3godogo3/CheapCopter/Documentation/Documentation.pdf

# GYMNASIUM JANA KEPLERA

### Parléˇrova 2/118, 169 00 Praha 6

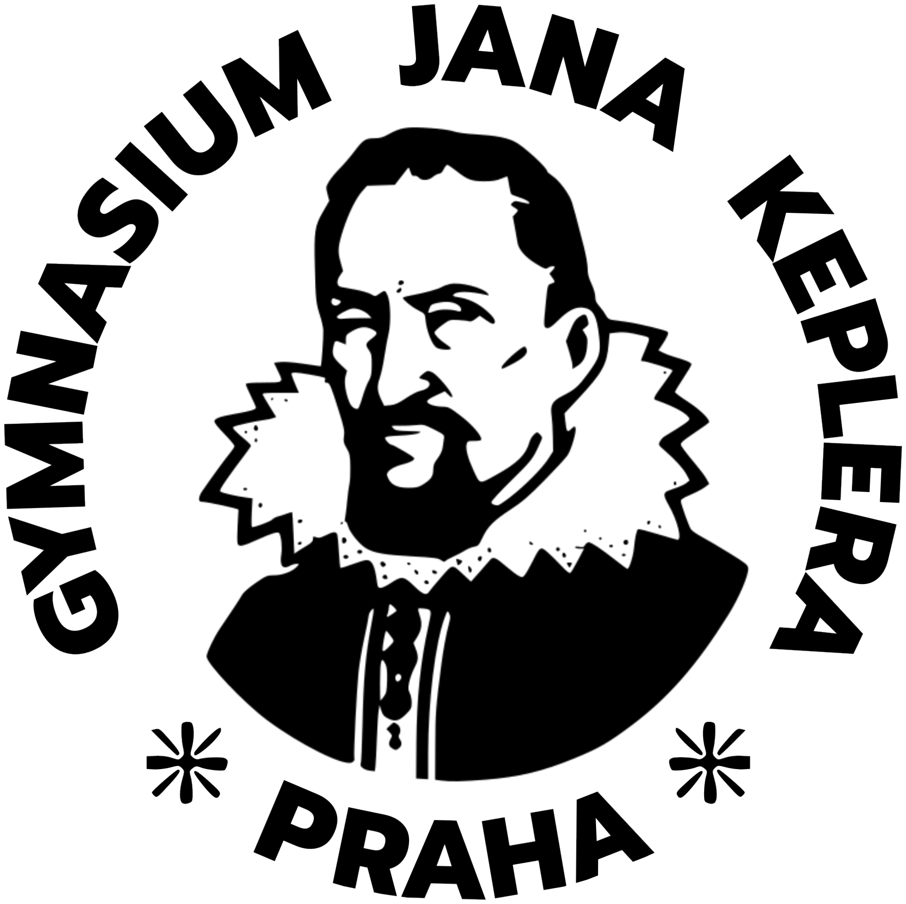
[picture p3: figure]

# CheapCopter

# Maturitní práce

### Autor: Filip Roˇcek

### Tˇrída: 4.A

### Školní rok: 2023/2024

### Pˇredmˇet: Informatika

### Vedoucí práce: Emil Miler

### Praha, 2024

# GYMNASIUM JANA KEPLERA Kabinet informatiky

# ZADÁNÍ MATURITNÍ PRÁCE

Student: | Filip Roˇcek
Tˇrída: | 4.A
Školní rok: | 2023/2024
Platnost zadání: | 19. 10. 2023
Vedoucí práce: | Emil Miler
Název práce: | CheapCopter

## Pokyny pro vypracování: Cílem této práce je vytvoˇrit cenovˇe dostupného drona, kterého si každý bude

moci vytvoˇrit doma sám, využívajíc soubor ˚u a návod ˚u vytvoˇrených touto prací,

## a také porovnat r ˚uzná možná ˇrešení s cílem najít nejvýhodnˇejší z hlediska

pomˇeru ceny a funkˇcnosti.

## URL repozitáˇre:

## https://github.com/3godogo3/CheapCopter

student | vedoucí práce

## V Praze dne 18. 10. 2023

# Prohlášení

Prohlašuji, že jsem svou práci vypracoval samostatnˇe a použil jsem pouze prameny a literaturu uvedené v seznamu bibliografických záznam ˚u. Nemám žádné námitky proti zpˇrístupˇnování této práce v souladu se zákonem ˇc. 121/2000 Sb. o právu autorském, o právech souvisejících s právem autorským a o zmˇenˇe nˇekterých zákon ˚u (autorský zákon) ve znˇení pozdˇejších pˇredpis ˚u.

V Praze dne 21. bˇrezna 2024 | Filip Roˇcek

# Abstrakt

Tato práce shrnuje tvorbu vlastního drona, kterého si kdokoliv se základními znalostmi pájení, dokáže doma vyrobit.

První ˇcást se zaobírá volbou vhodných komponent pro funkˇcnost tohoto projektu a jejich využitím.

Druhá kapitola rozebírá tvorbu a úpravou vlastního tištˇeného spoje, který propojuje všechny komponenty drona.

Tˇretí oddíl pojednává o souˇcástích tvoˇrených s pomocí 3D tiskárny, ucelujících celý projekt.

Poslední ˇcást ˇreší skuteˇcné použití a fungˇcnost vytvoˇreného drona.

# Obsah

1 Výbˇer souˇcástek | 2
2 Tištˇený spoj | 4
3 Tˇelo drona | 5
4 Použití | 6
5 Verze 2.0 | 8
Seznam použité literatury | 10

# 1. Výbˇer souˇcástek

# 1.1 Ovládání

## Procesor

Pro samotné fungování a ovládání drona je potˇreba procesor, který bude vzdálenˇe pˇrijímat pˇríkazy a pˇredávat je jednotlivým ˇcástem drona. Pro tento úkol jsem zvolil ˇcim ESP-WROOM32 pro jeho nízkou hmotnost, implementovanou podporu Wi-Fi a jeho dvˇe jádra, která umožˇnují prubˇeh více proces ˚u zároveˇn.

## Gyroskop

Pro automatické vyvažování drona musíme pˇridat také gyroskop, protože bouhužel námi vyraný procesor jej neobsahuje. Pro projekt nám bude vyhovovat tˇrí-osý gyroskop s akcelerometrem MPU-6050. Tato komponenta je schopna zmˇeˇrit odchylku na tˇrech hlavních osách, podle které upravíme rychlost motor ˚u pro vyrovnání drona. Zmˇeˇrené odchylky si nazveme "ROLL"pro osu x, "PITCH"pro osu y a "YAW"pro osu z.

# 1.2 Pohon

## Motory

Aby dron byl schopen letu, potˇrebujeme motory. Nejˇcastˇejším provedením je kvadrokoptéra, která má motory ˇctyˇri. Vybral jsem motory od BetaFPV, pro jejich nevelkou hmotnost, nízkou cenu a jejich ˇcasté použití v levných a lehkých dronech.[1] Výbˇer byl proveden po konzultaci s poradcem v obchodˇe FYFT.CZ, který mˇe obeznámil, že vypoˇcítat pˇresnˇe kolik motor je schopen unést a pˇredem vˇedˇet, který motor vybrat nelze, je to pouze o dobrém odhadu a zkušenostech. Pro správné fungování je potˇreba, aby se dva motory na diagonále otáˇcely stejným smˇerem a zbylé dva smˇerem opaˇcným, ˇcímž dosáhneme vynulování otáˇcení po ose z. Pokud by se všechny motory otáˇcely stejným smˇerem, dron by nám rotoval.

Výbˇer souˇcástek

L293D

Pro ovládání motoru využívám dva drivery L293D, kde každý ovládá dva motory. Tento driver funguje na principu dvou AND hradel, kde jedno je stále na hodnotˇe LOW a druhé má na vstupu hodnotu HIGH a PWM signál poskytnutý ESP. PWM signálem jsme schopni omezit rychlost otáˇcek a snížit tím rychlost stoupání.

# 1.3 Napájení

## Baterie

Nejvhodnˇejší baterií pro takovýto projekt je typ Li-Pol, protože jsou lehké, s velkou kapacitou a mohou se nabíjet narozdíl od jiných baterií. S limitním napˇetím našich motor ˚u hodnoceným na 5V potˇrebujeme dvojˇclánkovou Li-Pol baterii s napˇetím 7,4V, které pomocí souˇcástek v další ˇcásti snížíme na požadovaných 5V. Po spoˇcítání spotˇreby motor ˚u a ˇcip ˚u jsme se rozhodl pro baterii KAVAN Li-Po 860mAh/7,4V, která by mˇela vydržet pˇri nejvyšší zátˇeži pˇribližnˇe patnáct minut.

## Regulace

Náš dron potˇrebuje dvˇe napˇetí - 3,3V pro ESP a MPU a 5V pro L293D a motory. V prvním provedení jsem tohoto dosáhl za pomocí dvou lineárních regulátor ˚u napˇetí LM7805C zapojených do serie. Tento postup bohužel prakticky nefungoval, i když jsme dosáhli požadovaných napˇetí, první regulátor se ihned pˇrehˇrál na kritickou teplotu a vypínal se. Rešením bylo vymˇenit první regulátor ˇ z 7,4V na 5V za Step-Down converter, který je sice vˇetší a tˇežší, ale efektivnˇejší a nepˇrehˇrívá se.


Obrázek 1.1: Výstupní napˇetí v závislosti na vstupním u regulátoru LM7805C[2]

# 2. Tištˇený spoj

# 2.1 Design

Tvorba PCB zaˇcala schématem zapojení všech komponent. K tomuto úkolu jsem využil software KiCad, který je velmi intuitivní i pro úplné zaˇcáteˇcníky. Dále je potˇreba navrhnout samotné PCB. Pro náš projekt bude dostateˇcné nejlevnˇejší ˇrešení PCB a to pevné dvouvrstvé bez zlatých pin ˚u. Po doporuˇcení vedoucího práce byl pˇridán GND do celé plochy tištˇeného spoje, kde se nevyskytují jiné propoje, pro jednoduché propojení všechs komponent.

# 2.2 Objednání

Pro samotné vytvoˇrení tohoto tištˇeného spoje jsem si vybral stránku JLCPCB.COM, která umožˇnuje za velmi nízkou cenu(cca 100 Kˇc za pˇet kus ˚u PCB), nechat si vyrobit jakékoliv PCB. Jediná nevýhoda je lokace spoleˇcnosti. Sídlí v Cínˇe, a proto doprava trvala tˇri týdny. Byla možnost si pˇriplatit za ˇ doruˇcení do nˇekolika dn ˚u, ale ˇcástka by se vyšplhala i na 1000 Kˇc za samotnou dopravu, což je skoro vyšší ˇcástka než hodnota samotného dronu.

# 3. Tˇelo drona

# 3.1 Rám

Pro správnou funkˇcnost drona je zapotˇrebí správný pomˇer pevnosti a hmotnosti tˇela. Tohoto jsem dosáhl odhadem, kde první verze mˇela plné dno, ˇcímž byla konstrukce rámu znaˇcnˇe pevnˇejší, ale o nˇekolik desítek gram ˚u tˇežžší. V druhé verzi jsem ztenˇcil všechny stˇeny, ubral materiál dna a pˇridal nožicky pod jednotlivé motory pro lepší ochranu drát ˚u motor ˚u. Tímto se sice snížila pevnost, ale díky robustnosti samotného PCB to není znát, a zároveˇn se snížila hmotnost. Jako poslední jsem se rozhodl využít materiál PLA, se kterým se jednodušeji tiskne a je levnˇejší, protože vyšší pevnost jiných materiál ˚u jako napˇríklad ABS mi nepˇripadala nutná. Veškerá tvorba model ˚u byla provedena v programu Autodesk Fusion 360 a Prusa Slicer.

# 3.2 Vrtule

Pˇri první verzi modelu jsem se pokusil vymodelovat a vytisknout i vrtule, ale po dlouhé snaze, se mi nedaˇrilo vytvoˇrit ideální tvar. Z toho d ˚uvodu jsem využil model z internetu. Po jeho vytisknutí a testování jsem se ale dostal k závˇeru, že s mnˇe dostupným materiálem jsou vrtule pˇríliš tvrdé a kˇrehké, a proto jsem se uchýlil ke koupi 2"vrtulí. Tyto vrtule jsem vybral po konzultaci s poradcem z FYFT.CZ.

# 4. Použití

V této kapitole si popíšeme jak dron ovládat a zdali opravdu funguje.

# 4.1 Pˇripojení se

Po zapojení baterie se dron automaticky zapne. Nˇekolik vteˇrin na to se vytvoˇrí Wi-Fi access point, který se základnˇe jmenuje "Drone"a lze se k nˇemu pˇripojit za pomocí hesla "password". Jak jméno, tak heslo pro AP se dá zmˇenit v kódu pˇrepsáním promˇenných *ssid a *password. Návod na nahrání upraveného kódu se podívejte do kapitoly 4.3. Pokud dron chcete ovládat, je zapotˇrebí se na tento AP pˇripojit. Veškeré ovládání poté najdete ve vašem webovém prohlížeci na adrese "192.168.4.1". K ovládání doporuˇcuji používat mobilního telefonu, ale je možné využít i poˇcítaˇce.

# 4.2 Ovládání

Na webové stránce vidíte jednoduché GUI, s devíti tlaˇcítky - osm na samotné ovládání drona a jedno na updatování firmware. Pro zapnutí motor ˚u drona zmáˇcknˇete tlaˇcítko "ON". Dále pro vzlédnutí využijte levého dolního tlaˇcítka "UP"a pro pokles tlaˇcítka "DOWN". Pro pohyb do stran využijte ˇctyˇri tlaˇcítka urˇcena pro každý ze ˇctyˇr základních smˇer ˚u.

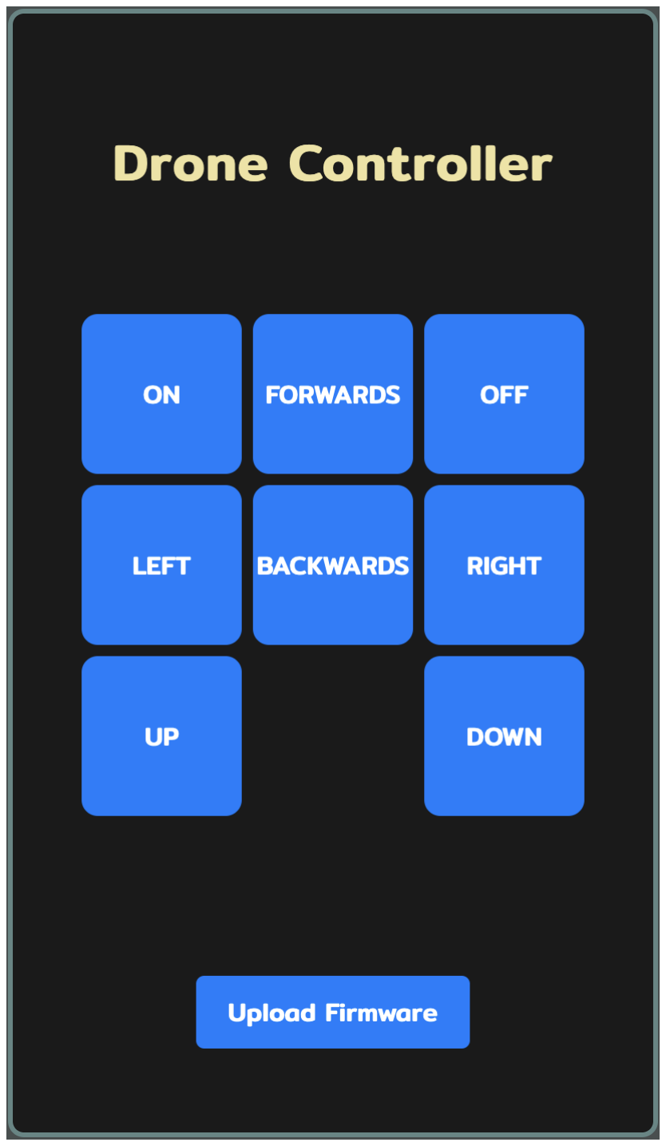
[picture p4: figure]

Obrázek 4.1: Webové rozhraní

Použití

# 4.3 Updatování

Zmˇenu firmware provádˇejte pouza na vlastní nebezpeˇcí. Pˇrepsání jakékoliv ˇcásti základního kódu m ˚uže zp ˚usobit nefunkˇcnost drona. Pokud jste se rozhodli si kód jakkoliv upravit, m ˚užete ho jednoduše nahrát pˇres webové rozhraní. Pokud se nacházíte na ovládacím panelu popsaném v pˇredchozí ˇcásti, zmáˇcknˇete dolní tlaˇcítka "Upload Firmware". Toto vás pˇresmˇeruje do updatovacího rozharní. Zaškrtnˇete políˇcko "Firmware"a vyberte binárku s vaším kódem. Bˇehem procesu flashování NEOD-POJUJTE dron od baterie.

# 4.4 Skuteˇcné použití

I pˇres veškerou snahu se dron není schopen sám zvednout. Je tomu tak z d ˚uvodu pˇríliš vysoké hmotnosti drona, ze kterého motory nemají dostateˇcný tah pro vzlet. Více než polovina hmotnosti je tvoˇrena samotnou baterií. Dále by bylo dobré zvážit použití jiných vrtulí. Všechny ostatní funkce fungují. Jediné co by na dronu s nižší hmotností bylo potˇreba doladit jsou konstanty u vyvažování pomocí gyroskopu a základní rychlost motor ˚u, kterou se otáˇcejí bez zadaných pˇríkaz ˚u.

# 5. Verze 2.0

V závˇereˇcné kapitole navrhuji teoreticky vhodnˇejší a funkˇcní ˇrešení tohoto projektu a popisuji zmˇeny, které provádím na hardwaru drona.

# 5.1 PCB

U první verze tištˇeného spoje jsem nemˇel zkušenost s potˇrebnou velikosti samotné desky. V nové verzi jsou komponenty navzájem znaˇcnˇe pˇriblíženy. Tím snížíme hmotnost drona o nˇekolik gram ˚u a nebudeme plýtvat materiálem zbyteˇcným volným místem na desce. Dále jsem opravil chybu, kde ESP pin EN nebyl na tištˇeném spoji pˇripojen na 3,3V. Na samotném PCB jsem vymˇenil jeden z regulátor ˚u za Step-Down converter. Poslední úpravou je pˇridání pˇrepínaˇce pˇred baterii, aby se dron mohl vypnout i jiným zp ˚usobem, než-li odpojením baterie.

# 5.2 Baterie

Po testování drona na plný výkon jsem se rozhodl, že kapacita 780mAh má nevýhodný pomˇer v ˚uˇci hmotnosti a pro druhou verzi drona jsem se rozhodl zvolit baterii o skoro poloviˇcní kapacitˇe pro snížení hmotnosti ze 44g na 18g. Dron sice nebude schopen létat zdaleka tak dlouho, ale bude létat. Tato zmˇena vyžaduje ještˇe jednu úpravu na PCB a to výmˇenu JST-XH 2pin za 3pin.

# 5.3 Vrtule

Pro teoretické zlepšení tahu vymˇením vrtule, za doporuˇcené pˇrímo na stránkách motoru[1] a to za trojlisté 48mm vrtule Micro Whoop. Je možné, že tento krok je zbyteˇcný, ale z d ˚uvodu intenzivnˇejšího proudˇení vzduchu ho zvolím.

# Závˇer

Tento projekt mˇel za cíl najít levnˇejší a dostupnˇejší ˇrešení drona pro lidi, kteˇrí rádi tvoˇrí a radˇeji ušetˇrí tím, že si nˇeco složí sami než-li si koupí pˇredražené sestavené ˇrešení.

Tohoto jsem podle mého názoru dosáhl, protože cena vychází pˇribližnˇe na 1000 Kˇc. Samozˇrejmˇe pokud nˇekdo nemá napˇríklad pájecí sadu a musel by si ji poˇrídit, vyšlo by to na více než cenu bˇežnˇe dostupných dron ˚u. Toto ale nem ˚užeme zapoˇcítat do ceny samotného drona.

Bohužel se mi nepovedlo vytvoˇrit létající verzi drona. Vytvoˇril jsem funkˇcní kód a návrh ˇrešení.

# Seznam použité literatury

[Bet] | BetaFPV. Brushed motors. Accessed on 23-02-2024. url: https : / / betafpv . com /
| products/8-5x20mm-16000kv-brushed-motors-2cw-2ccw. (https://betafpv.com/products/8-5x20mm-16000kv-brushed-motors-2cw-2ccw)
[Jam] Jameco. Regulator Datasheet. Accessed on 23-02-2024. url: https : / / datasheet .
| octopart.com/LM7805CT-NOPB-Texas-Instruments-datasheet-7273848.pdf. (https://datasheet.octopart.com/LM7805CT-NOPB-Texas-Instruments-datasheet-7273848.pdf)
