3godogo3/CheapCopter/HW/v2/CheapCopterv2.stl

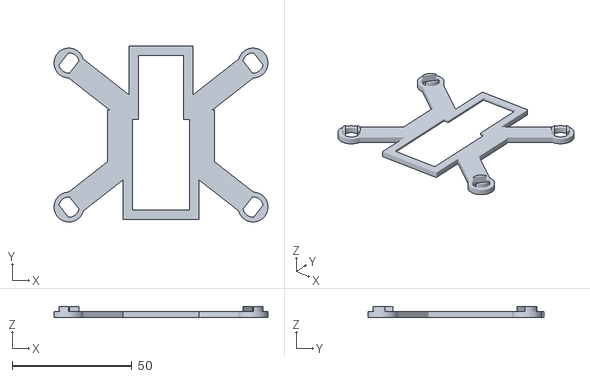
[picture p6: CAD file, 2024-03-02]
HW/v2/CheapCopterv2.stl
89.5 x 73.6 x 4.60
