3godogo3/CheapCopter/HW/v1/CheapCopter.stl

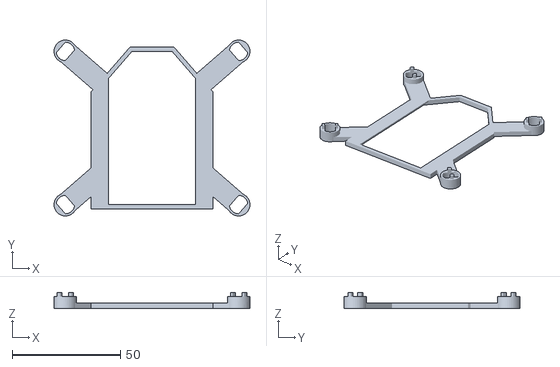
[picture p7: CAD file, 2024-03-02, an earlier design]
HW/v1/CheapCopter.stl
90.5 x 81.2 x 7.50
