3godogo3/CheapCopter/HW/v1/CheapCopter.kicad_pcb

## KiCad design HW/v1/CheapCopter.kicad_pcb (2024-01-24, an earlier design)

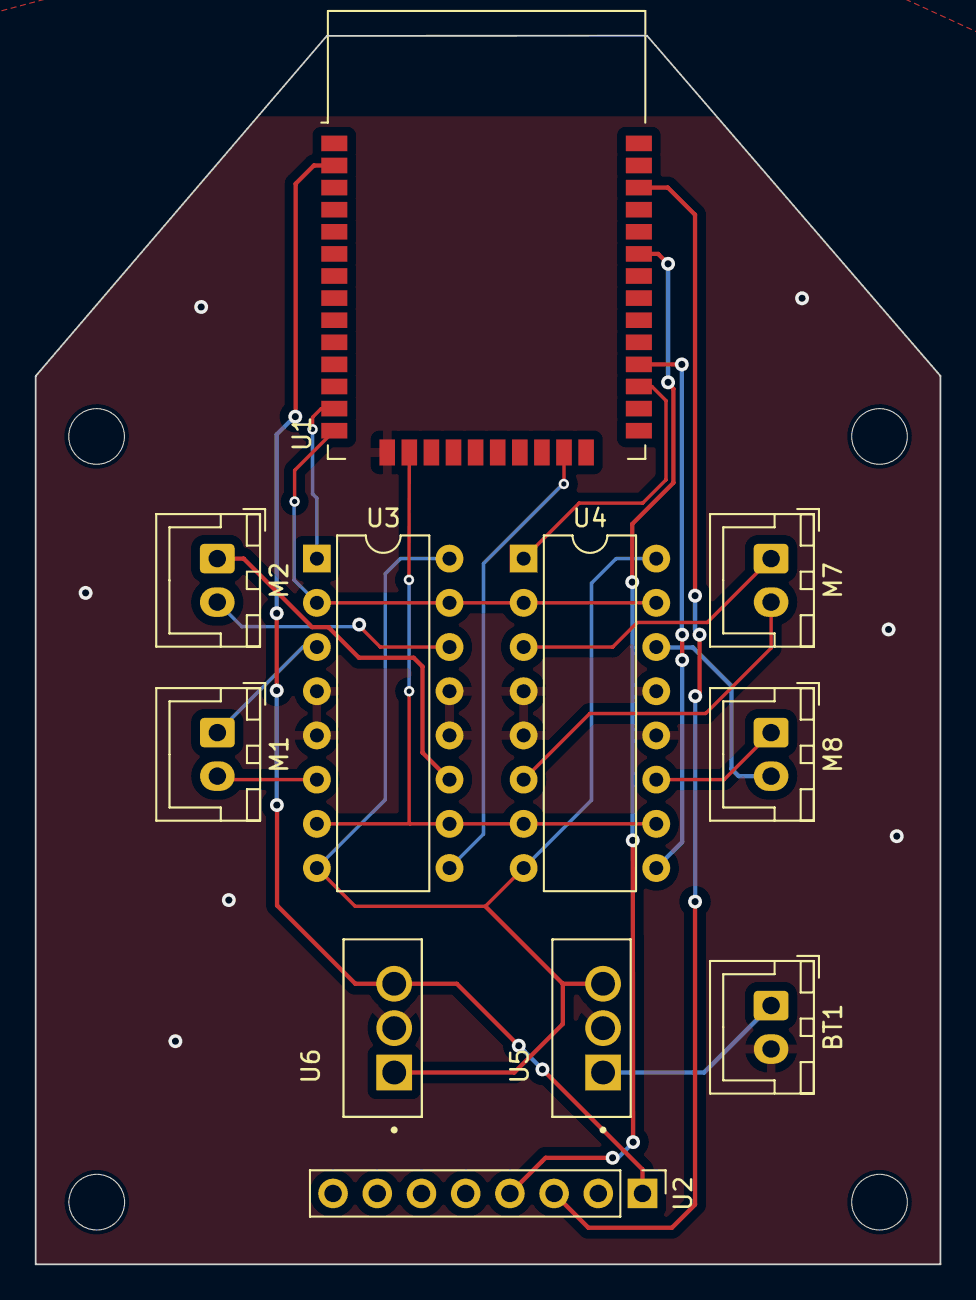
[picture p8: board CheapCopter.kicad_pcb from above]

Board: 2 copper layers, 52.0 x 70.6 mm, 11 parts (0 on the bottom side), 20 nets.

Parts:
BT1: JST_XH_B2B-XH-A_1x02_P2.50mm_Vertical
M1, M2, M7, M8: 3-5V; JST_XH_B2B-XH-A_1x02_P2.50mm_Vertical
U1: ESP32-WROOM-32
U2: PinHeader_1x08_P2.54mm_Vertical
U3, U4: L293D; DIP-16_W7.62mm
U5, U6: L7805; TO255P1020X450X2000-3

Connections:
+3V3: U1.2 (VDD), U2.1, U6.3 (OUT)
+5V: U3.8 (VCC2), U3.16 (VCC1), U4.8 (VCC2), U4.16 (VCC1), U5.3 (OUT), U6.1 (IN)
+7.4V: BT1.1 (+), U5.1 (IN)
GND: BT1.2 (-), U1.15 (GND), U2.2, U3.4 (GND), U3.5 (GND), U3.12 (GND), U3.13 (GND), U4.4 (GND), U4.5 (GND), U4.12 (GND), U4.13 (GND), U6.2 (GND)
unnamed: M1.1 (+), U3.3 (1Y)
unnamed: M1.2 (-), U3.6 (2Y)
unnamed: M2.1 (+), U3.11 (3Y)
unnamed: M2.2 (-), U3.14 (4Y)
unnamed: M7.1 (+), U4.3 (1Y)
unnamed: M7.2 (-), U4.6 (2Y)
unnamed: M8.1 (+), U4.11 (3Y)
unnamed: M8.2 (-), U4.14 (4Y)
unnamed: U1.14 (IO12), U3.2 (1A), U3.15 (4A), U4.2 (1A), U4.15 (4A)
unnamed: U1.16 (IO13), U3.7 (2A), U3.10 (3A), U4.7 (2A), U4.10 (3A)
unnamed: U1.13 (IO14), U3.1 (EN1,2)
unnamed: U1.23 (IO15), U3.9 (EN3,4)
unnamed: U1.27 (IO16), U4.1 (EN1,2)
unnamed: U1.28 (IO17), U4.9 (EN3,4)
unnamed: U1.33 (IO21), U2.4
unnamed: U1.36 (IO22), U2.3
