3godogo3/CheapCopter/(commit log)

2023-10-31 First circuit schematic and pcb file
    [CheapCopter.kicad_pcb, CheapCopter.kicad_sch]
2024-01-24 First code
    Added code for WiFi AP, OTA and basic wireless controlling
    [CheapCopter.kicad_pcb, CheapCopter.kicad_sch]
2024-02-26 v2
    added v2 pcb files
    [CheapCopter.kicad_pcb, CheapCopter.kicad_sch]
2024-02-28 Code Update
    Added missing commands
    Changed serial connection to telnet
    Added selfbalancing
    [dron.ino]
2024-03-02 Body model v2
    [CheapCopter.stl, CheapCopterv2.stl]
2024-03-20 replace telnet with web ui
    [dron.ino]
